danigr99727/StrontiumEERover/20180514_153907.jpg

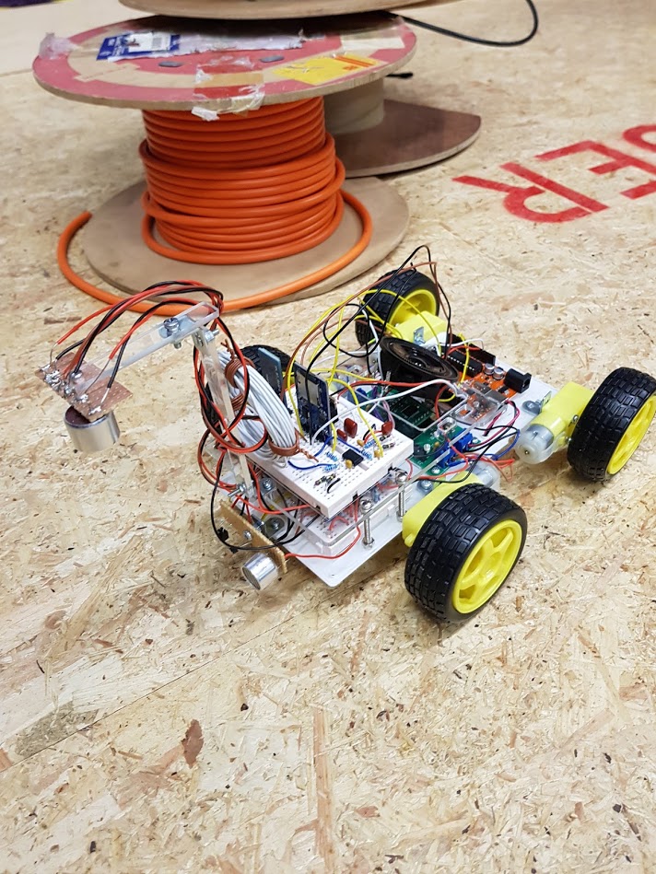
20180514_153907.jpg
